zapta/ble_stepper_motor_analyzer/docs/ESP-WROOM-32-pinout.png

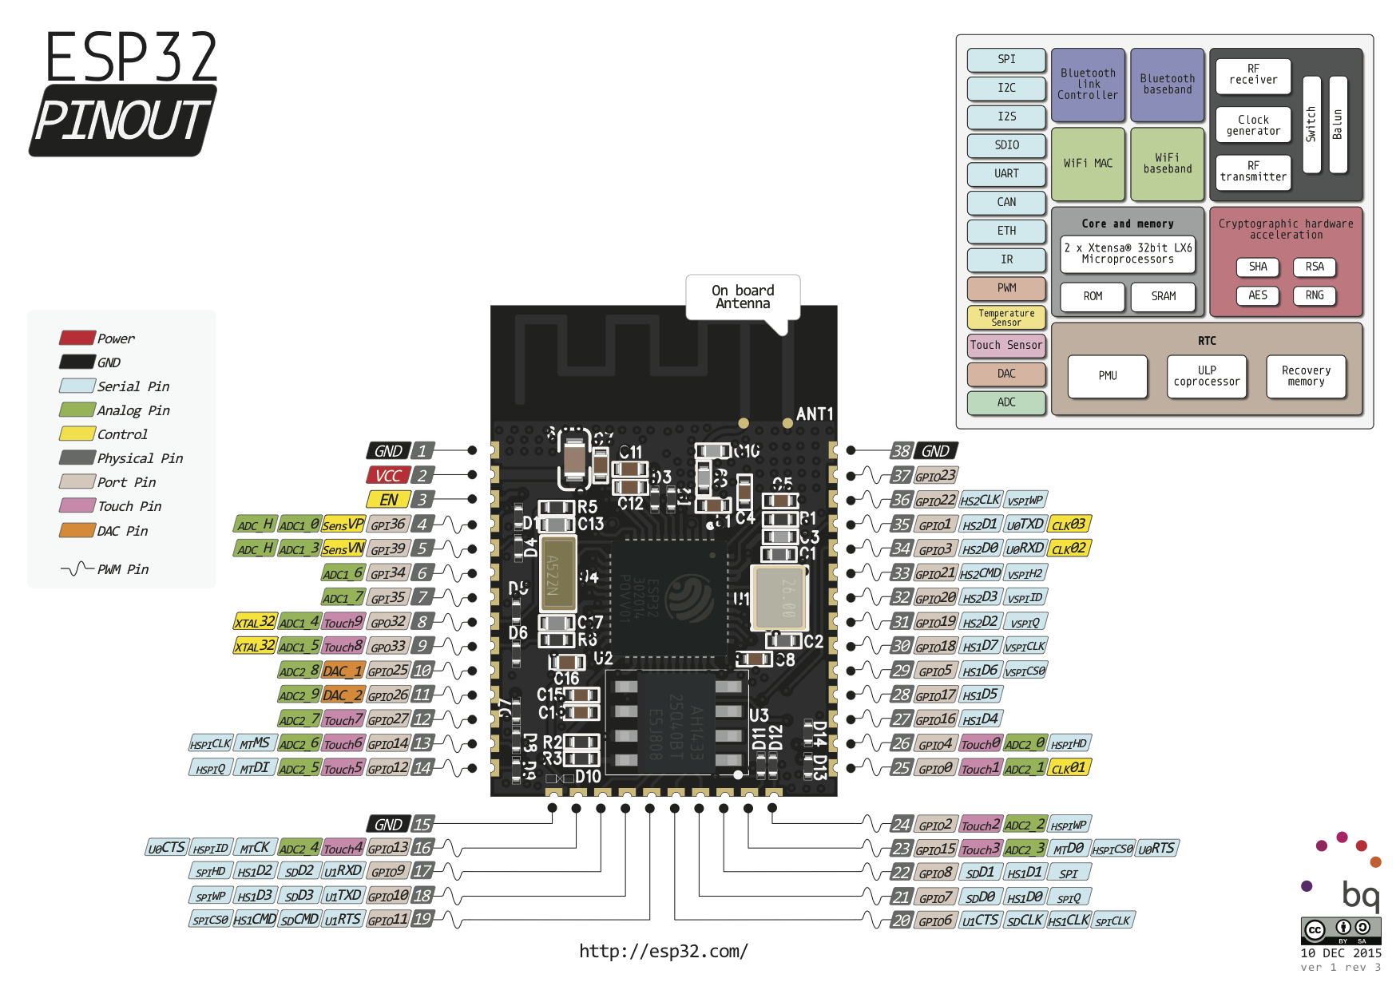
docs/ESP-WROOM-32-pinout.png
