zapta/ble_stepper_motor_analyzer/www/board_ortho.png

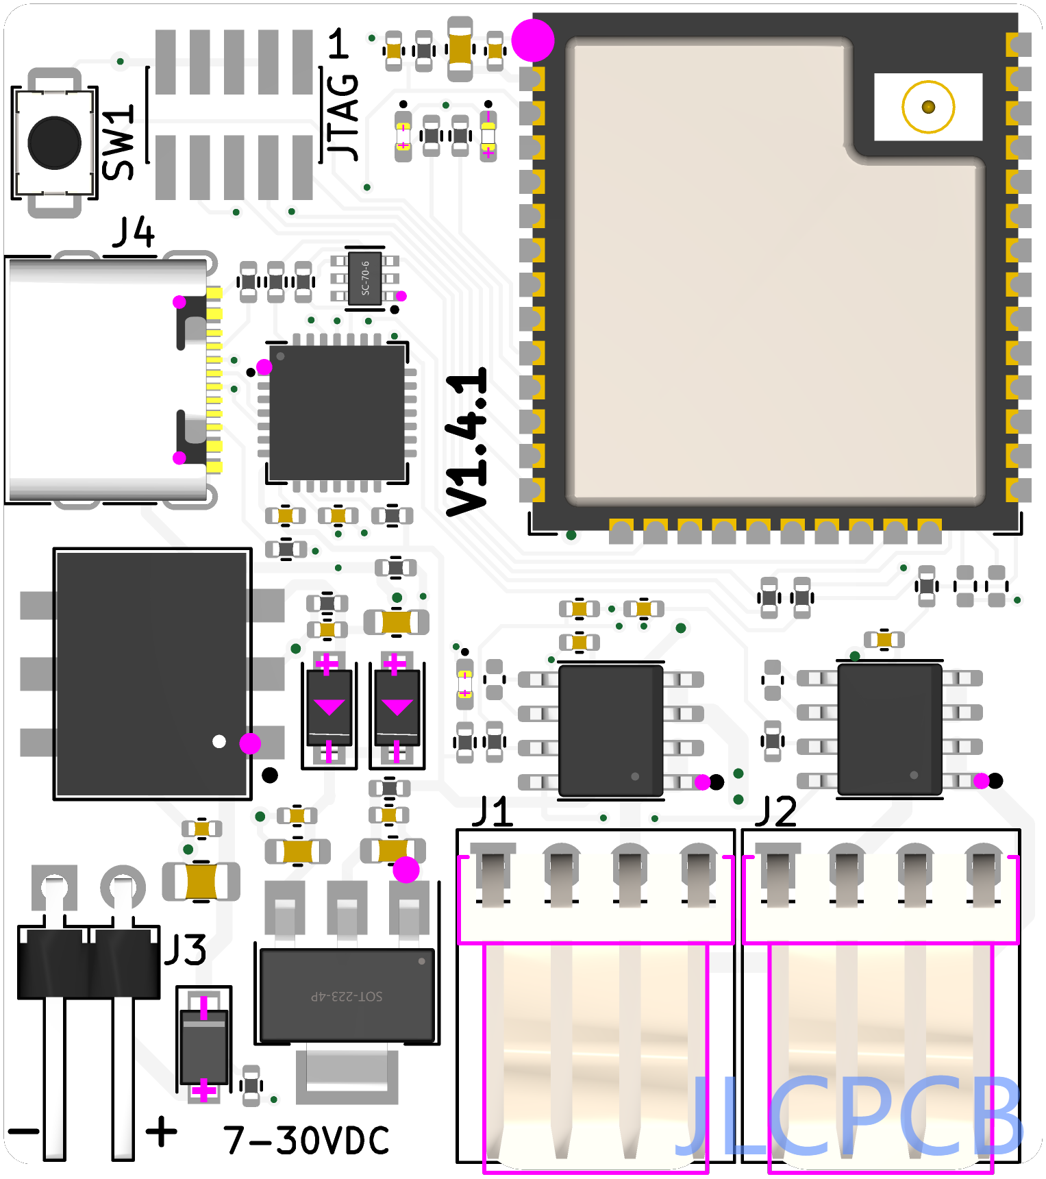
www/board_ortho.png
