zapta/ble_stepper_motor_analyzer/www/jlcpcb_top.png

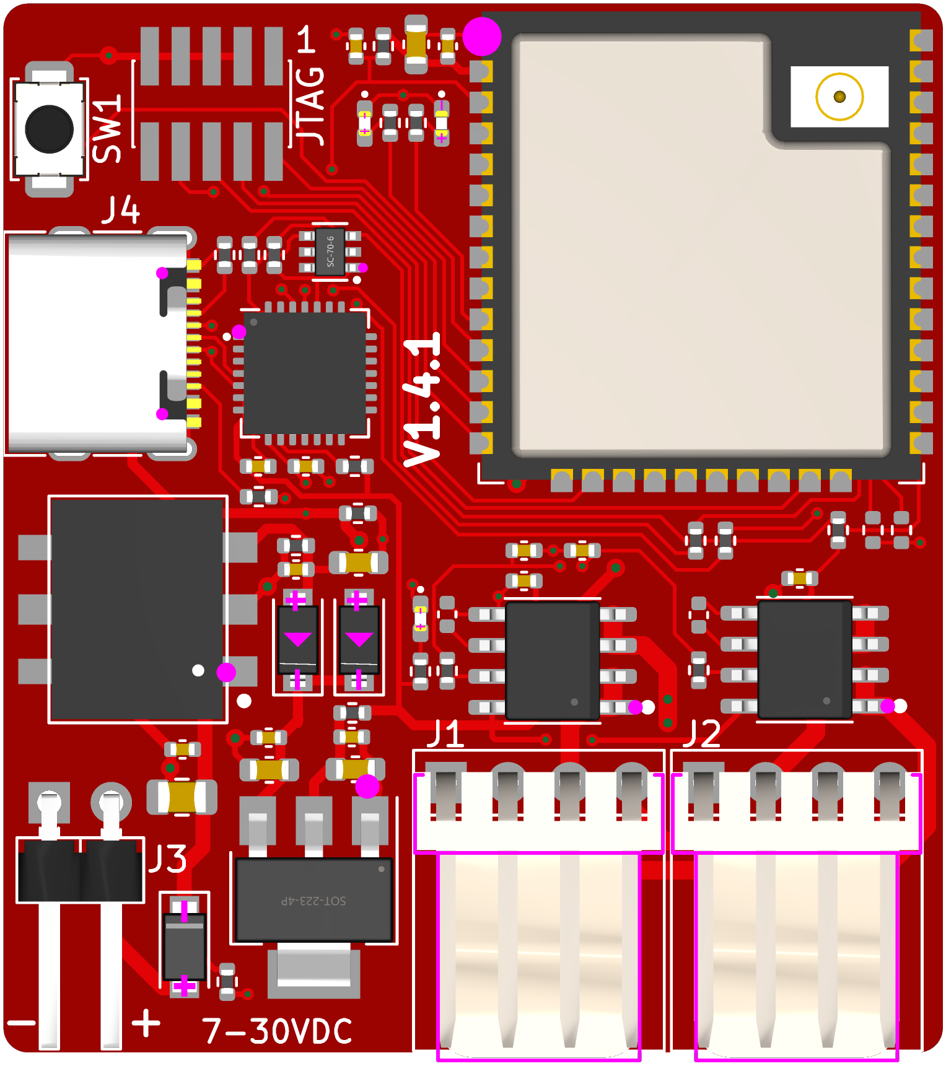
www/jlcpcb_top.png
