zapta/ble_stepper_motor_analyzer/docs/ESP32 Pins.xlsx

Sheet: WROOM
No. | Name | Type | GPIO | True GPIO | RTC_GPIO | ADC | TOUCH | DAC | I2C | SPI | SD/SDIO/MMC Host Controller | UART | Parallel QSPI | JTAG | SDIO Slave | Ethernet | SD/SDIO/MMC Host Controller
25 | IO00 | I/O | GPIO00 | No | RTC_GPIO11 | ADC2_CH01 | TOUCH1 |  |  |  |  |  |  |  |  | EMAC_TX_CLK |  | Low for programming
35 | TXD0 | I/O | GPIO01 | No |  |  |  |  |  |  |  | U0TXD |  |  |  | EMAC_RXD2
24 | IO02 | I/O | GPIO02 | No | RTC_GPIO12 | ADC2_CH02 | TOUCH2 |  |  |  | HS2_DATA0 |  | HSPIWP |  |  |  | HS2_DATA0 | floarting or low for flashing
34 | RXD0 | I/O | GPIO03 | No |  |  |  |  |  |  |  | U0RXD
26 | IO04 | I/O | GPIO04 |  | RTC_GPIO10 | ADC2_CH0 | TOUCH0 |  |  |  | HS2_DATA1 |  | HSPIHD |  |  | EMAC_TX_ER | HS2_DATA1
29 | IO05 | I/O | GPIO05 |  |  |  |  |  |  | SS/CS |  |  | VSPICS0 |  |  | EMAC_RX_CLK | HS1_DATA6
20 | SCK/CLK* | I/O | GPIO06 | No | UNUSABLE !!! (Flash memory) |  |  |  |  |  |  | U1CTS | SPICLK |  | SD_CLK |  | HS1_CLK
21 | SDO/SD0* | I/O | GPIO07 | No | UNUSABLE !!! (Flash memory) |  |  |  |  |  |  | U2RTS | SPIQ |  | SD_DATA0 |  | HS1_DATA0
22 | SDI/SD1* | I/O | GPIO08 | No | UNUSABLE !!! (Flash memory) |  |  |  |  |  |  | U2CTS | SPID |  | SD_DATA1 |  | HS1_DATA1
17 | SHD/SD2* | I/O | GPIO09 | No | UNUSABLE !!! (Flash memory) |  |  |  |  |  |  | U1RXD | SPIHD |  | SD_DATA2 |  | HS1_DATA2
18 | SWP/SD3* | I/O | GPIO10 | No | UNUSABLE !!! (Flash memory) |  |  |  |  |  |  | U1TXD | SPIWP |  | SD_DATA3 |  | HS1_DATA3
19 | SCS/CMD* | I/O | GPIO11 | No | UNUSABLE !!! (Flash memory) |  |  |  |  |  |  | U1RTS | SPICS0 |  |  |  | HS1_CMD
14 | IO12 | I/O | GPIO12 | No | RTC_GPIO15 | ADC2_CH05 | TOUCH5 |  |  |  | HS2_DATA2 |  | HSPIQ | MTDI |  | EMAC_TXD3 | HS2_DATA2 | Must not be high during boot!
16 | IO13 | I/O | GPIO13 |  | RTC_GPIO14 | ADC2_CH04 | TOUCH4 |  |  |  | HS2_DATA3 |  | HSPID | MTCK |  | EMAC_RX_ER | HS2_DATA3
13 | IO14 | I/O | GPIO14 |  | RTC_GPIO16 | ADC2_CH06 | TOUCH6 |  |  |  | HS2_CLK |  | HSPICLK | MTMS |  | EMAC_TXD2 | HS2_CLK
23 | IO15 | I/O | GPIO15 |  | RTC_GPIO13 | ADC2_CH03 | TOUCH3 |  |  |  | HS2_CMD |  | HSPICS0 | MTDO |  | EMAC_RXD3 | HS2_CMD | Prevents startup log
27 | IO16 | I/O | GPIO16 | Not available on WROVER |  |  |  |  |  |  |  | U2RXD |  |  |  | EMAC_CLK_OUT | HS1_DATA4 | PSRAM for the WROVER
28 | IO17 | I/O | GPIO17 | Not available on WROVER |  |  |  |  |  |  |  | U2TXD |  |  |  | EMAC_CLK_OUT_180 | HS1_DATA5 | PSRAM for the WROVER
30 | IO18 | I/O | GPIO18 |  |  |  |  |  |  | SCLK |  |  | VSPICLK |  |  |  | HS1_DATA7
31 | IO19 | I/O | GPIO19 |  |  |  |  |  |  | MISO |  | U0CTS | VSPIQ |  |  | EMAC_TXD0
33 | IO21 | I/O | GPIO21 |  |  |  |  |  | SDA1 |  |  |  | VSPIHD |  |  | EMAC_TX_EN
36 | IO22 | I/O | GPIO22 |  |  |  |  |  | SCL1 |  |  | U0RTS | VSPIWP |  |  | EMAC_TXD1
37 | IO23 | I/O | GPIO23 |  |  |  |  |  |  | MOSI |  |  | VSPID |  |  |  | HS1_STROBE
10 | IO25 | I/O | GPIO25 |  | RTC_GPIO06 | ADC2_CH08 |  | DAC_1 |  |  |  |  |  |  |  | EMAC_RXD0
11 | IO26 | I/O | GPIO26 |  | RTC_GPIO07 | ADC2_CH09 |  | DAC_2 |  |  |  |  |  |  |  | EMAC_RXD1
12 | IO27 | I/O | GPIO27 |  | RTC_GPIO17 | ADC2_CH07 | TOUCH7 |  |  |  |  |  |  |  |  | EMAC_RX_DV
8 | IO32 | I/O | GPIO32 |  | RTC_GPIO09 | ADC1_CH04 | TOUCH9 |  |  |  |  |  |  |  |  |  |  | XTAL_32K_P (32.768kHz crystal oscillator input)
9 | IO33 | I/O | GPIO33 |  | RTC_GPIO08 | ADC1_CH05 | TOUCH8 |  |  |  |  |  |  |  |  |  |  | XTAL_32K_N (32.768kHz crystal oscillator outut)
6 | IO34 | I | GPIO34 | No | RTC_GPIO04 | ADC1_CH06 |  |  |  |  |  |  |  |  |  |  |  | No internal pullup
7 | IO35 | I | GPIO35 | No | RTC_GPIO05 | ADC1_CH07 |  |  |  |  |  |  |  |  |  |  |  | No internal pullup
4 | SENSOR_VP | I | GPIO36 | No | RTC_GPIO00 | ADC1_CH0 |  |  |  |  |  |  |  |  |  |  |  | No internal pullup
5 | SENSOR_VN | I | GPIO39 | No | RTC_GPIO03 | ADC1_CH03 |  |  |  |  |  |  |  |  |  |  |  | No internal pullup

Sheet: ESP32 Chip
Name | No. | Type |  |  |  |  |  |  |  |  | Function
VDDA | 1 | P | Analog power supply (2.3V ~ 3.6V)
LNA_IN | 2 | I/O | RF input and output
VDD3P3 | 3 | P | Power supply (2.3V ~ 3.6V)
VDD3P3 | 4 | P | Power supply (2.3V ~ 3.6V)
SENSOR_VP | 5 | I | GPIO36 | ADC_PRE_AMP | ADC1_CH0 |  |  |  |  |  | RTC_GPIO0 Note: Connects a 270 pF capacitor from SENSOR_VP to SENSOR_ CAPP w
SENSOR_CAPP | 6 | I | GPIO37 | ADC_PRE_AMP | ADC1_CH1 |  |  |  |  |  | RTC_GPIO1 Note: Connects a 270 pF capacitor from SENSOR_VP to SENSOR_ CAPP w
SENSOR_CAPN | 7 | I | GPIO38 | ADC1_CH2 | ADC_PRE_AMP |  |  |  |  |  | RTC_GPIO2 Note: Connects a 270 pF capacitor from SENSOR_VN to SENSOR_ CAPN w
SENSOR_VN | 8 | I | GPIO39 | ADC1_CH3 | ADC_PRE_AMP |  |  |  |  |  | RTC_GPIO3 Note: Connects a 270 pF capacitor from SENSOR_VN to SENSOR_ CAPN w
CHIP_PU | 9 | I | High: On; enables the chip Low: Off; resets the chip Note: Do not leave the CHIP_PU pin floating.
VDET_1 | 10 | I | GPIO34 | ADC1_CH6 |  |  |  |  |  |  | RTC_GPIO4
VDET_2 | 11 | I | GPIO35 | ADC1_CH7 |  |  |  |  |  |  | RTC_GPIO5
32K_XP | 12 | I/O | GPIO32 | ADC1_CH4 | 32K_XP (32.768 kHz crystal oscillator input) | TOUCH9 |  |  |  |  | RTC_GPIO9
32K_XN | 13 | I/O | GPIO33 | ADC1_CH5 | 32K_XN (32.768 kHz crystal oscillator output) | TOUCH8 |  |  |  |  | RTC_GPIO8
GPIO25 | 14 | I/O | GPIO25 | ADC2_CH8 | DAC_1 | RTC_GPIO6 |  |  |  |  | EMAC_RXD0
GPIO26 | 15 | I/O | GPIO26 | ADC2_CH9 | DAC_2 | RTC_GPIO7 |  |  |  |  | EMAC_RXD1
GPIO27 | 16 | I/O | GPIO27 | ADC2_CH7 | TOUCH7 | RTC_GPIO17 |  |  |  |  | EMAC_RX_DV
MTMS | 17 | I/O | GPIO14 | ADC2_CH6 | TOUCH6 | RTC_GPIO16 | MTMS | HSPICLK | HS2_CLK | SD_CLK | EMAC_TXD2
MTDI | 18 | I/O | GPIO12 | ADC2_CH5 | TOUCH5 | RTC_GPIO15 | MTDI | HSPIQ | HS2_DATA2 | SD_DATA2 | EMAC_TXD3
VDD3P3_RTC | 19 | P | Input power supply for RTC IO (1.8V ~ 3.6V)
MTCK | 20 | I/O | GPIO13 | ADC2_CH4 | TOUCH4 | RTC_GPIO14 | MTCK | HSPID | HS2_DATA3 | SD_DATA3 | EMAC_RX_ER
MTDO | 21 | I/O | GPIO15 | ADC2_CH3 | TOUCH3 | RTC_GPIO13 | MTDO | HSPICS0 | HS2_CMD | SD_CMD | EMAC_RXD3
GPIO2 | 22 | I/O | GPIO2 | ADC2_CH2 | TOUCH2 | RTC_GPIO12 | HSPIWP | HS2_DATA0 |  |  | SD_DATA0
GPIO0 | 23 | I/O | GPIO0 | ADC2_CH1 | TOUCH1 | RTC_GPIO11 | CLK_OUT1
GPIO4 | 24 | I/O | GPIO4 | ADC2_CH0 | TOUCH0 | RTC_GPIO10 | HSPIHD | HS2_DATA1 | SD_DATA1 |  | EMAC_TX_ER
GPIO16 | 25 | I/O | GPIO16 | HS1_DATA4 | U2RXD |  |  |  |  |  | EMAC_CLK_OUT
VDD_SDIO | 26 | P | Output power supply: 1.8V or the same voltage as
GPIO17 | 27 | I/O | GPIO17 | HS1_DATA5 | U2TXD |  |  |  |  |  | EMAC_CLK_OUT_180
SD_DATA_2 | 28 | I/O | GPIO9 | SD_DATA2 | SPIHD | HS1_DATA2 | UNUSABLE !!! (Flash memory) |  |  |  | U1RXD
SD_DATA_3 | 29 | I/O | GPIO10 | SD_DATA3 | SPIWP | HS1_DATA3 | UNUSABLE !!! (Flash memory) |  |  |  | U1TXD
SD_CMD | 30 | I/O | GPIO11 | SD_CMD | SPICS0 | HS1_CMD | UNUSABLE !!! (Flash memory) |  |  |  | U1RTS
SD_CLK | 31 | I/O | GPIO6 | SD_CLK | SPICLK | HS1_CLK | UNUSABLE !!! (Flash memory) |  |  |  | U1CTS
SD_DATA_0 | 32 | I/O | GPIO7 | SD_DATA0 | SPIQ | HS1_DATA0 | UNUSABLE !!! (Flash memory) |  |  |  | U2RTS
SD_DATA_1 | 33 | I/O | GPIO8 | SD_DATA1 | SPID | HS1_DATA1 | UNUSABLE !!! (Flash memory) |  |  |  | U2CTS
GPIO5 | 34 | I/O | GPIO5 | VSPICS0 | HS1_DATA6 |  |  |  |  |  | EMAC_RX_CLK
GPIO18 | 35 | I/O | GPIO18 | VSPICLK |  |  |  |  |  |  | HS1_DATA7
GPIO23 | 36 | I/O | GPIO23 | VSPID |  |  |  |  |  |  | HS1_STROBE
VDD3P3_CPU | 37 | P | Input power supply for CPU IO (1.8V ~ 3.6V)
GPIO19 | 38 | I/O | GPIO19 | VSPIQ | U0CTS |  |  |  |  |  | EMAC_TXD0
GPIO22 | 39 | I/O | GPIO22 | VSPIWP | U0RTS |  |  |  |  |  | EMAC_TXD1
U0RXD | 40 | I/O | GPIO3 | U0RXD |  |  |  |  |  |  | CLK_OUT2
U0TXD | 41 | I/O | GPIO1 | U0TXD | CLK_OUT3 |  |  |  |  |  | EMAC_RXD2
GPIO21 | 42 | I/O | GPIO21 | VSPIHD |  |  |  |  |  |  | EMAC_TX_EN
VDDA | 43 | P | Analog power supply (2.3V ~ 3.6V)
XTAL_N | 44 | O | External crystal output
XTAL_P | 45 | I | External crystal input
VDDA | 46 | P | Digital power supply for PLL (2.3V ~ 3.6V)
CAP2 | 47 | I | Connects to a 3 nF capacitor and 20 kÎ© resistor in parallel
CAP1 | 48 | I | Connects to a 10 nF series capacitor to ground
GND | 49 | P | Ground
