zapta/ble_stepper_motor_analyzer/3D/shipping_covrer.stl

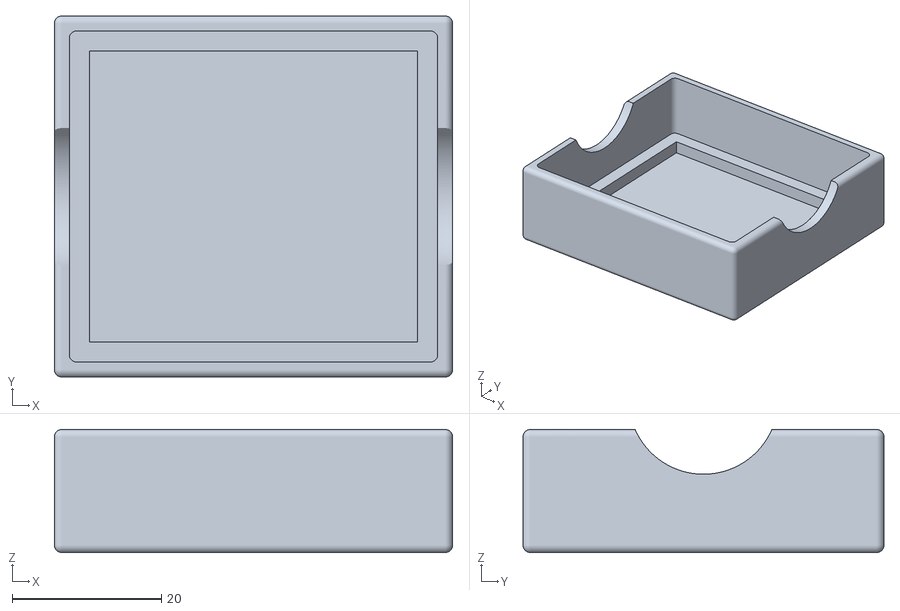
[picture p12: CAD file, 2023-02-09]
3D/shipping_covrer.stl
53.4 x 48.4 x 16.5
