zapta/ble_stepper_motor_analyzer/kicad/3d_models/tactile_switch.step

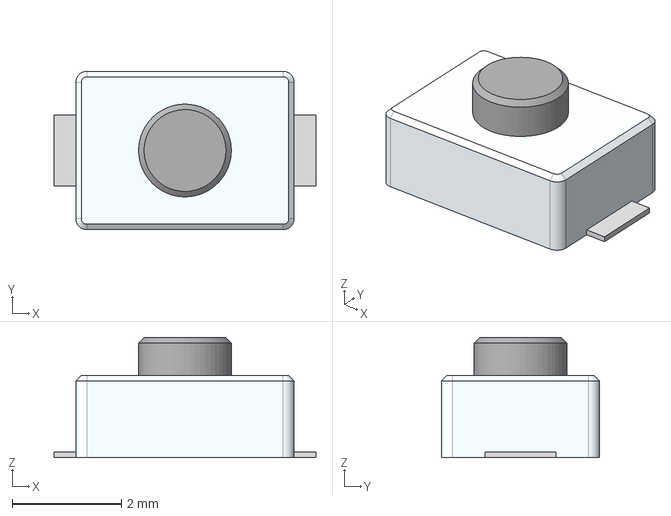
[picture p13: CAD file, 2023-03-21]
kicad/3d_models/tactile_switch.step
4.80 x 2.90 x 2.20 mm
