zapta/ble_stepper_motor_analyzer/3D/carrier.stl

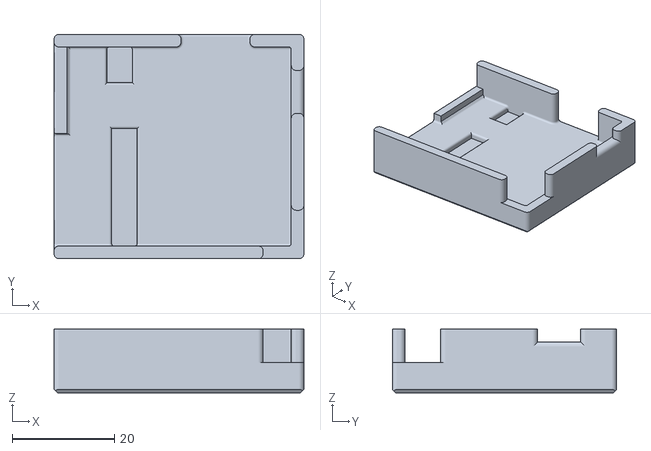
[picture p14: CAD file, 2023-02-09]
3D/carrier.stl
49.0 x 44.0 x 12.5
