zapta/ble_stepper_motor_analyzer/kicad/3d_models/K7805MT-500R4.step

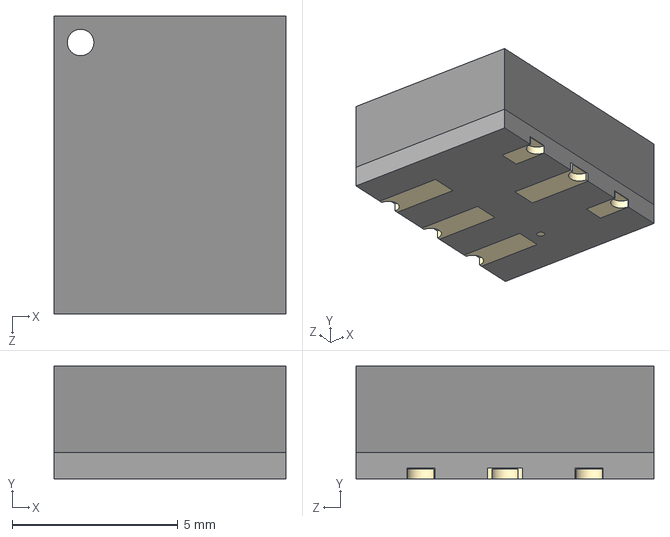
[picture p15: CAD file, 2023-03-20]
kicad/3d_models/K7805MT-500R4.step
7.00 x 3.40 x 9.00 mm
