zapta/ble_stepper_motor_analyzer/kicad/3d_models/kf2510_4p_right_angle.step

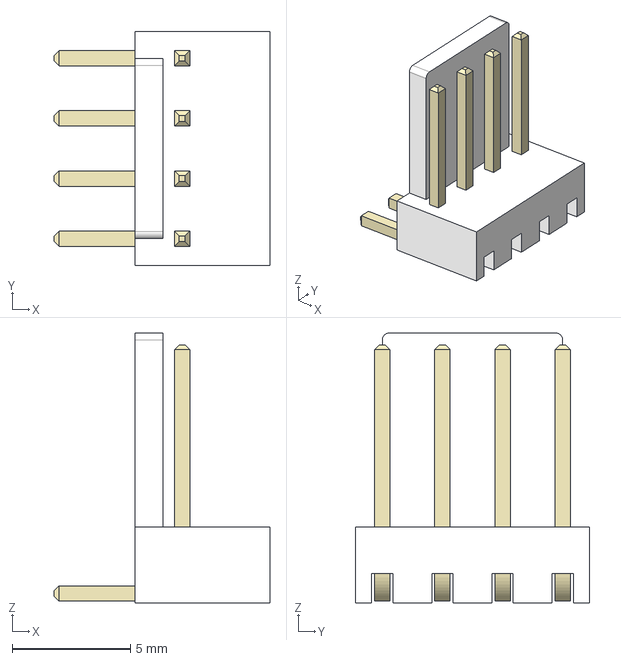
[picture p16: CAD file, 2023-03-20]
kicad/3d_models/kf2510_4p_right_angle.step
9.10 x 9.90 x 11.4 mm
