zapta/ble_stepper_motor_analyzer/kicad/3d_models/HRO_TYPE-C-31-M-12.step

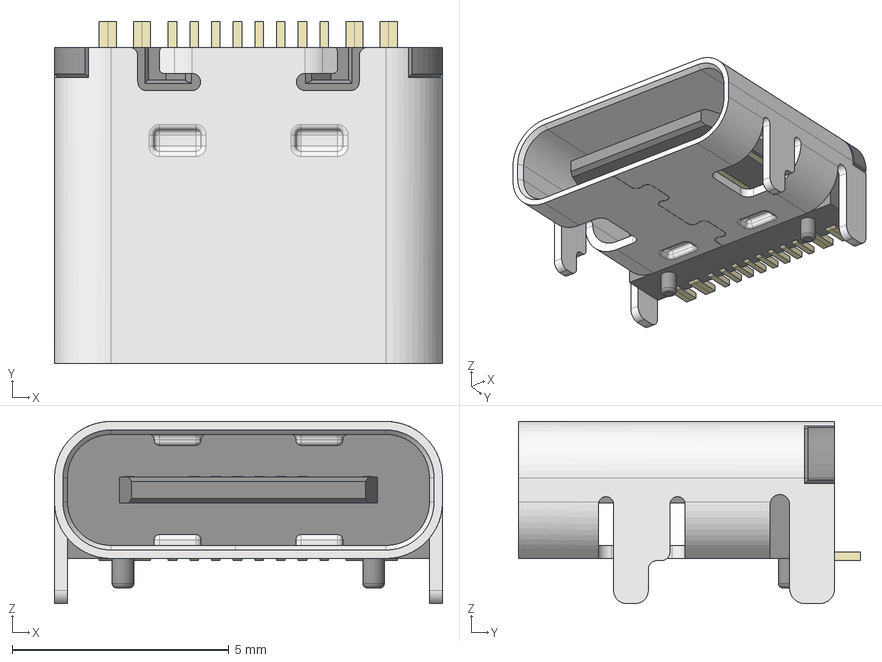
[picture p17: CAD file, 2023-03-20]
kicad/3d_models/HRO_TYPE-C-31-M-12.step
8.95 x 7.90 x 4.20 mm
