zapta/ble_stepper_motor_analyzer/TODO.txt

* Step tracking is not stable with very low stepper current, e.g. ~150ma after a Duet Home All function.

* In the device info, report also software version.

* Use github workflows to automate relase creation
