zapta/ble_stepper_motor_analyzer/(threads)

Thread 1 (2023-06-05):

Ordering at JLCPCB

Sineos, 2023-06-05:
Since I have never ordered something at JLC, some stupid questions:
1. 1.4.2 is good to go or are any major updated planned in the new future?
2. Ordering process:
   1. Upload `gerber.zip` --> Use JLC defaults
   2. Upload `bom.csv` and `positions.csv`
   3. C15,C18,R17,R18 are marked as `DNP` (= Do not populate / place?) --> Do not select them as well as the JTAG?
3. Anything else to mind?

Thanks for providing this cool design.

zapta, 2023-06-05:
Hi Sineos,

1. I ordered and tested successfully 1.4.1 (and have three units in my
printer).  1.4.2, is the same as 1.4.1 but automatically migrated to Kicad
7. I didn't test 1.4.2  it myself but somebody else made a few tweaks to
that design and ordered successfully. The tweaks involve changing the
connectors to more common ones with 3D controllers from China.

If all you want is hassle free one or two boards, they may be available for
sale in a month or two. I am not involved but will link on the main page
anybody that make them available to the community.

2. That's correct. If you consider making firmware development yourself,
add also the JTAG connector, at least on the board you want to use for
development (it's not a must but having a hardware debugger is handy). If
you just want to make and use the standard firmware than no need for the
JTAG connectors.

BTW, after I ordered my last batch, I think that JLCPCB now requires
'standard' level service to assemble the ESP32 modules.

3. What else? You will also need antennas, connectors, etc. If you are
handy with soldering, when you test the first unit, remove r16, and verify
that you have 3.3v on c11 with usb and/or external power. r16 is a short
that was placed for this reason, to disconnect the circuitry from the power
supply.

Wish you success, and I will try to help if needed, but basically this
reference design is 'as is' with no warranties.

Zapta

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

Sineos, 2023-06-06:
Thanks a lot @zapta

zapta, 2023-06-08:
Sineos, FYI, a BLE Stepper Motor Analyzer is now available from a third party.

https://vector3d.co.uk/product/stepper-motor-analyser/

Closed 2023-06-06.

Thread 2 (2023-06-10):

Max current

dzid26, 2023-06-10:
If the design uses CC6920BSO-5A, shouldn't it be -/+5A range? The readme says +/-2.5A per phase

zapta, 2023-06-11:
It needs 5v supply to have the +/-5A range with 400mv/A sensitivity but in
this design we run it on 3.3V only. But anyway, +/-2.5A peak is more than
needed for most 3D printers.

BTW, there is a better current sensor with the same pinout but it's very
hard to find since the pandemic, especially non fake ones (I did get fakes
once from Aliexpress, it's easy to identify since pins 1,2 and 3,4
respectively should be shorted internally). The ACS70331EESATR-2P5B3  has
higher bandwidth, lower noise, and lower output impedance. The output
impedance is important because the ESP32 ADC has relatively low output
impedance and loads the CC6920BSO-5A such that we don't really get 400mv/A.
This is why we calibrated it using actual measurements with ESP32 and not
based on the datasheet.

https://github.com/zapta/ble_stepper_motor_analyzer/blob/main/platformio/src/acquisition/acq_consts.h#L11

The two configuration resistors R17, R18 were designed to support 4
different kinds of sensors, to let the firmware know which one is
installed, but CC6920BSO-5A is the only one we used in this design because
it's available on JLCPCB.

Zapta

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

dzid26, 2023-06-11:
> It needs 5v supply to have the +/-5A range with 400mv/A sensitivity but in this design we run it on 3.3V only.

Are you saying that the real sensitivity of CC6920BSO-5A is 400mV/A ?
But as someone also pointed out (https://forum.duet3d.com/post/292525) the data sheet says 264mV/A. Which makes sense because this chip us designed for 3.3V.
And you mentioned in the forum that impedance maybe is not an issue..

zapta, 2023-06-19:
Yes, you are right, I may mixed it with another sensor.

BTW, I see that digikey carries now some Allegro GMR sensors, they have higher bandwidth and significantly lower noise. Ideally the +/-2.5A with 400mv/A, but the +/-5A with 200mv/A can still be more quieter than the one from JLCPCB.

file:///C:/Users/user/Downloads/ACS70331-Datasheet.pdf

(Having all the components available from JLCPCB was a key design goal here, hence the selection of the inferior current sensor. In previous designs which I soldered myself I used the Alegro ones, e.g. https://github.com/zapta/simple_stepper_motor_analyzer/blob/main/kicad/stepper_analyzer.pdf )

dzid26, 2023-06-20:
Today I designed a voltage-measuring circuit that filters scales down, and offsets the phase voltage. It is using a differential opamp configuration - so the ground doesn't have to be connected.
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
https://everycircuit.com/circuit/5156012797198336/biased-differential-amplifier-

I don't know how noisy it will be and what can be done with it, but power calculation should be possible.

But now I am thinking - it would be interesting to use the same structure (but with different gain and less filtering) to also measure current across 0.1ohm shunt resistors. I think I will put it in parallel with CC6920BSO to compare the noise of both solutions.

I wonder if the noise you mention is also related to flawed ADC from ESP32 and additionally lack of filtering of analog VDD3p3 in Wroom module. Would be cool to replace it with a [custom design](https://youtu.be/yxU_Kw2de08?t=418), but I have enough of Kicad.

zapta, 2023-06-20:
I believe that the noise is dominated by the JLCPCB current sensor because when I hooked the ESP32 to a ACS70331  +/-2.5A the noise reduction was very visible.

As for your circuit, one thing that the magnetic current sensors provide is galvanic isolation which the opamp circuit doesn't provide, so make sure to get the connections and voltages right so you don't damage anything or experiment with an ESP32 that runs on a battery.

There are also isolated amplifiers if you want to get fancy ;-). Never used them but they seem interesting. E.g. https://www.ti.com/product/AMC3311-Q1

Thread 3 (2023-06-10):

Repo size

dzid26, 2023-06-10:
The repo size is approaching 1GB.
Can you move the /releases (analyzer.exe, analyzer, firmware) to github releases and [rewrite git history](https://stackoverflow.com/questions/11050265/remove-large-pack-file-created-by-git) while still not many people has forked it?

I also like putting PCB gerbers, pdfs and [ibom](https://github.com/zapta/ble_stepper_motor_analyzer/blob/main/kicad/bom/ibom.html) in release as well.

Nordic sniffer probably also can be removed.

dzid26, 2023-06-10:
I did [it](https://docs.github.com/en/authentication/keeping-your-account-and-data-secure/removing-sensitive-data-from-a-repository) in my [fork](https://github.com/dzid26/ble_stepper_motor_analyzer).

```
java -jar bfg.jar --delete-files stepper_monitor-2023-06-10_153440.zip
java -jar bfg.jar --delete-files stepper_monitor-2023-06-10_145755.zip
java -jar bfg.jar --delete-files nrf_sniffer_for_bluetooth_le_4.1.1.zip
java -jar bfg.jar --delete-files ibom.html
java -jar bfg.jar --delete-files positions.csv
java -jar bfg.jar --delete-files gerber.zip
java -jar bfg.jar --delete-files bom.csv
java -jar bfg.jar --delete-files bootloader.bin
java -jar bfg.jar --delete-files firmware.bin
java -jar bfg.jar --delete-files partitions.bin
java -jar bfg.jar --delete-files analyzer
java -jar bfg.jar --delete-files analyzer.exe
java -jar bfg.jar --delete-files bluetooth_spec_Core_v4.2.pdf
java -jar bfg.jar --delete-files bluetooth_spec_Core_v5.3.pdf
```

```
git push --force
git reflog expire --expire=now --all && git gc --prune=now --aggressive
```

Now it's 157MB + [releases](https://github.com/dzid26/ble_stepper_motor_analyzer/releases/tag/0.1.4.V3D).

zapta, 2023-06-10:
Hi @dzid26,

Can you reply here with your your suggestions for repo structure changes and I will check with @AdamV3D if it will not disturb his fork at https://github.com/AdamV3D/ble_stepper_motor_analyser.   A text description should do, e.g. 'move file x to location z'.

BTW, the esptool is included in the release to allow users to perform firmware upgrade in the field.

Thanks,
Zapta

zapta, 2023-06-10:
... another useful change would be to generate the 3 python binaries on the
github servers instead of locally. I think github supports this kind of
functionality (for Windows, Mac, and Linux) but never used it and not sure
if it's included with the free plan.

Zapta.

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

dzid26, 2023-06-10:
I [moved](https://github.com/dzid26/ble_stepper_motor_analyzer/commit/446ccf57ebdc2c621b7545003fa04f5d7a8207e6) esptool to the tools folder, because it made sense.

I think releases should be fairly rare, so it's ok if they contain Kicad, firmware, and PC - all together.  If someone wants the latest stuff they will probably be compiling things themselves anyway.

Yes, Github Actions should be able to generate firmware and even gerberas. I have [examples](https://github.com/dzid26/StepperServoCAN/actions/runs/5217466463) of [such ](https://github.com/dzid26/StepperServo-hardware/actions/runs/4039163312) generation (with resulted files at the bottom) however I never figured out how to make it appear in releases. Still useful if someone just needs the latest bin.

@AdamV3D 's fork would break in the sense that automated merging would stop being possible as it will have "unrelated history".
I actually [merged](https://github.com/dzid26/ble_stepper_motor_analyzer/pull/1) their changes already in my fork, but I removed the branding.

AdamV3D, 2023-06-10:
I'm not too fussed about what goes where, as long as there is some logic to it and you let me know what I need to change.

dzid26, 2023-06-10:
@zapta
If you are happy with the file list that I pruned from the repo, you can simply add my fork to your remotes `git remote add dzid_repo https://github.com/dzid26/ble_stepper_motor_analyzer.git`, then `git reset --hard be5677df7288d70ab088b6f44482682492ed3467` to be on my be5677df7288d70ab088b6f44482682492ed3467 (or this one 237ca533ef51c63852ebdcca41b90d53d2e325d2), and at the end you `git push --force` to Github.

Thread 5 (2023-06-24):

Running Analyzer App on a Raspberry Pi

thijstriemstra, 2023-06-24:
> The Analyzer App ('the app'). This is a Python program that runs on a Windows, MaC OSX, or Linux PC, and displays the stepper information in real time in a graphical view.

After some research it looks like PyQT is used for the analyzer app so it should be able to run on a Raspberry Pi? I have a Raspberry Pi 3 with a HyperPixel display running KlipperScreen, would be great to use the app on that device (besides KlipperScreen) and use the touchscreen etc.

Was  the app ever tested on a Raspberry Pi?

zapta, 2023-06-25:
Hi Thijs,

I tested the app on Ubuntu with a X86 processor but never a Raspberry.
Would be interesting to give it a try if you can.

The BLE communication is done using Bleak Python library
https://github.com/hbldh/bleak which may use native drivers so I would
check first if it supports The Raspberry Pie.

Please keep us updated.

Zapta

On Sat, Jun 24, 2023 at 11:20 AM Thijs Triemstra ***@***.***>
wrote:

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

Thread 6 (2023-06-25):

[Q] Working?

Sineos, 2023-06-25:
I have received a bunch from JLCPCB.
I'd be grateful if you could take a look at https://drive.google.com/file/d/1WODmPNKCghbgU1xkgDg3Vb5cSd95qMt8/view
Is this what is to be expected, i.e. does it work like it should?

Basically just
```
G0 F9000 X245.0
G0 F9000 X1.0
```
repeated on a 0.9 stepper with 64 microsteps.

zapta, 2023-06-25:
Looks very good.  The driver maintains a clean signal and high current at
high speed.

I cannot see well the current graph (third from the top). Ideally it should
be flat except for idle timeout where some drivers lower the current when
the motor doesn't move. Can you send me a closeup that shows the signal and
the Y axis?

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

Sineos, 2023-06-25:
Playing around with the new toy currently :-)

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

What I'm wondering:

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

Why is this so asymmetrical, i.e. the Lissajous figure shifted to the right and top and the oscilloscope graph also shifted upwards?

zapta, 2023-06-25:
Yes, I think that you need to calibrate the zeros of your sensor, it's a
one time thing, and it may also solve the fluctuations in the third graph
from the top.

1. With the power off, disconnect the stepper cables (to have zero current)
2. Power the analyzer the analyzer
3. Press on the button on the PCB for a few seconds until the LED will
blink 3 times, to indicate that the zero calibration values were stored
properly on the device.

Please let me know how it worked for you.

Also, since you have multiple boards, you may want to look into the 'nick
name' feature https://github.com/zapta/ble_stepper_motor_analyzer . You can
assign board names such as MOTOR_X or EXTRUDER and then use those names
instead of the numeric ids.

Zapta.

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

zapta, 2023-06-25:
... the third graph (current) shows the radius of the circle you see in the
phase graph so if it's not centered by zero calibration, the radius is
different in different angles and thus the third graph shows fluctuation,
depending at what phase it happened to sample the X and Y currents. Very
interesting. Never seen it before because I always zero calibrate the
sensors first.

Zapta.

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

Sineos, 2023-06-26:
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

*Sigh* A classic case of RTFM. Thanks for your support. Appreciated!

zapta, 2023-06-26:
Awesome.  Thanks for updating me.

I learned something new.

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

Sineos, 2023-06-26:
Thanks for the work and effort you put into providing this!

Closed 2023-06-26.

Thread 9 (2023-11-16):

Max stepper voltage? 48V?

ganzgustav22, 2023-11-16:
Does it support steppers that run 48V?

7-30V is just the supply voltage, right?

zapta, 2023-11-16:
That's correct. I believe that 48V steppers should be fine.

It's just a matter of insulation of the current sensors, connectors, PCB
traces, etc. There is no electronic component that is directly exposed to
the 48V.

On Thu, Nov 16, 2023 at 11:43 AM ganzgustav22 ***@***.***>
wrote:

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
