zapta/ble_stepper_motor_analyzer/kicad/stepper_monitor.pdf

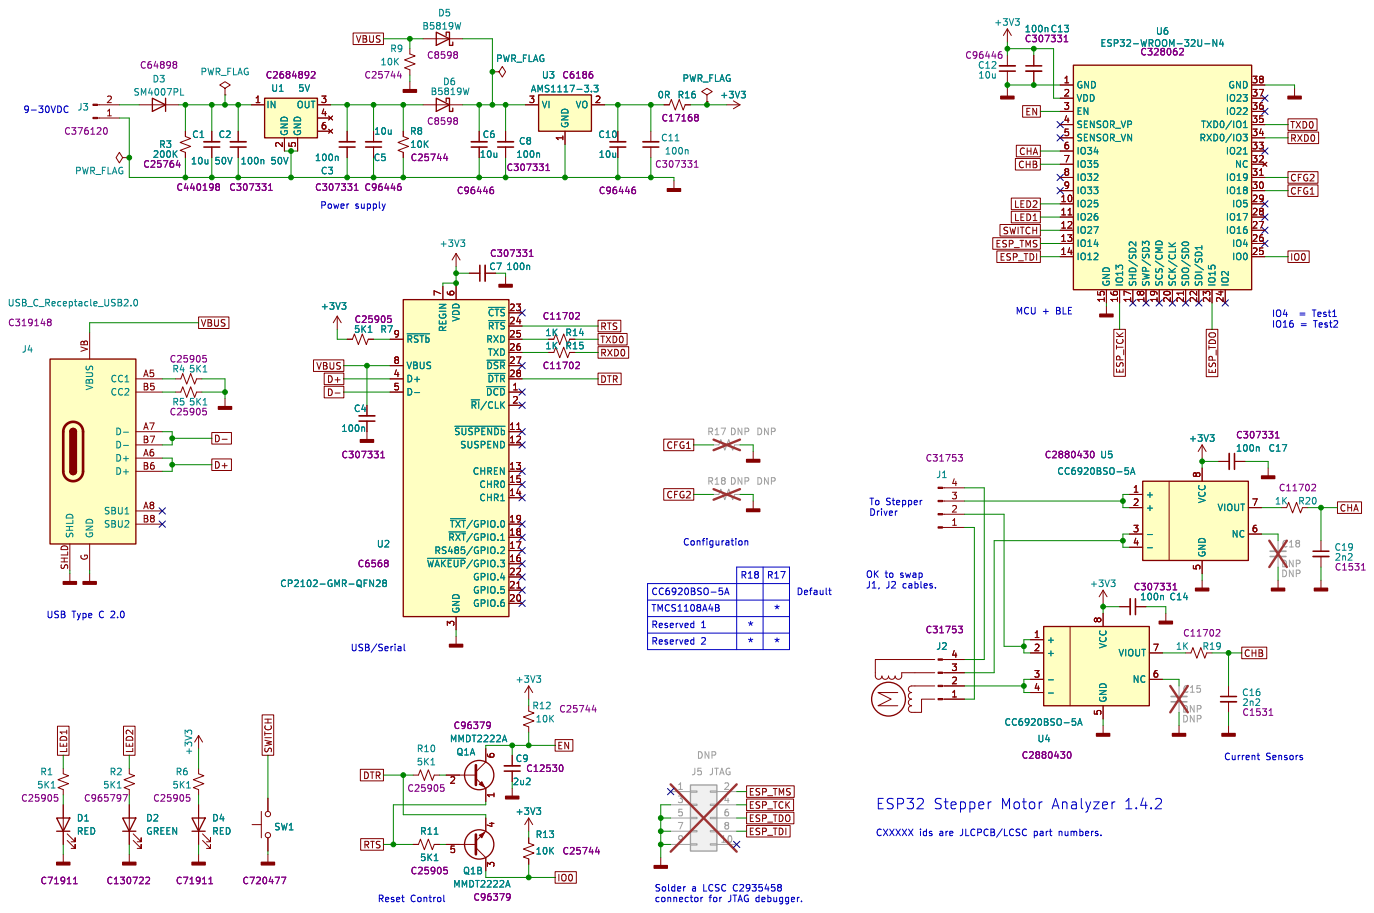
[picture p18: page 1]

To Stepper Driver OK to swap
