zapta/ble_stepper_motor_analyzer/hardware/stepper_monitor.pdf

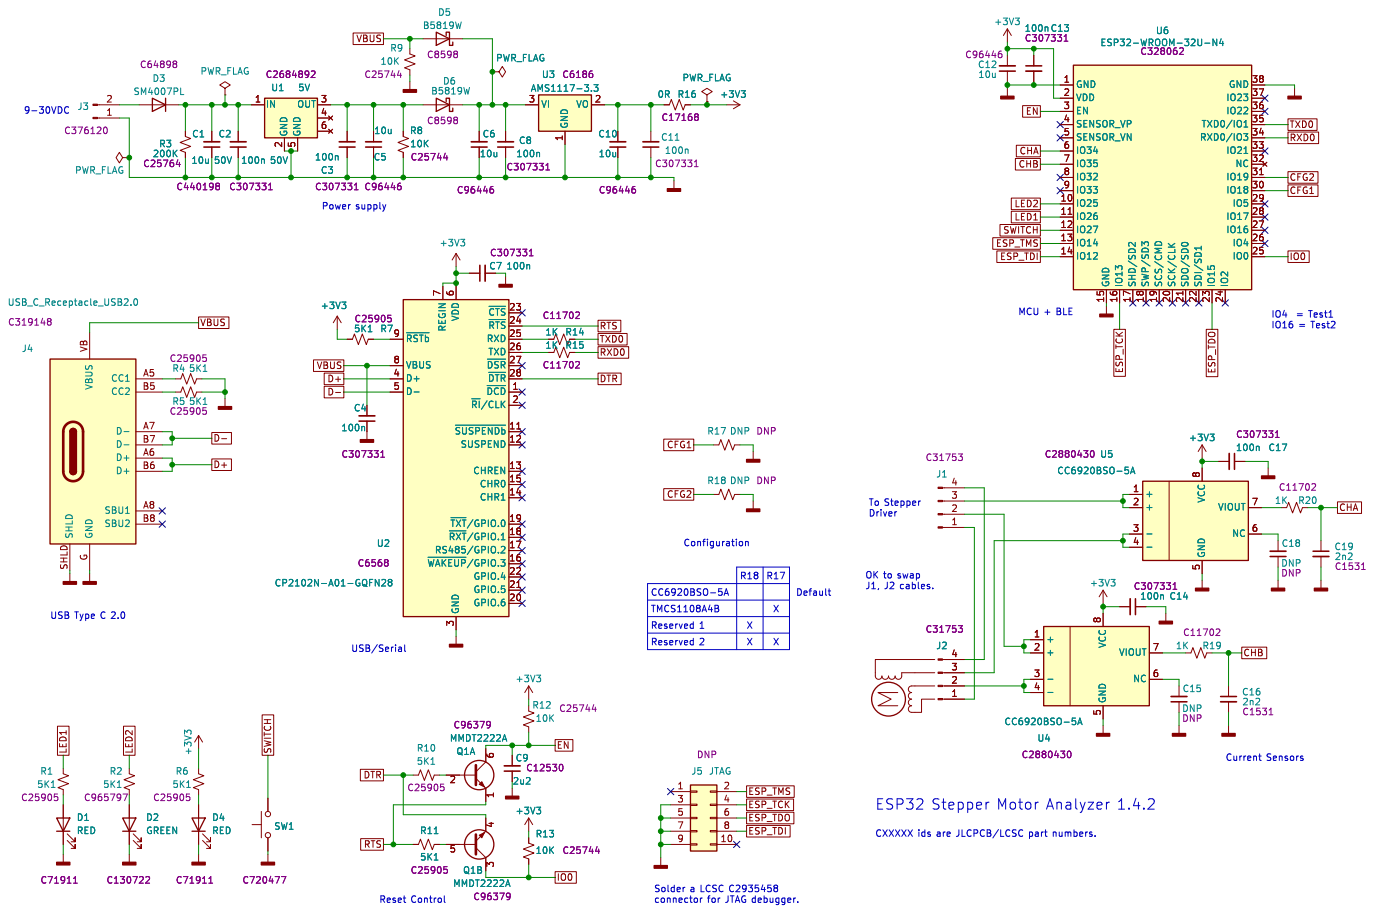
[picture p19: page 1]

7 VBUS 8 ~{RSTb} 9 U2 CP2102N-A01-GQFN28 C6568 +3V3 C15 DNP DNP C16
