zapta/ble_stepper_motor_analyzer/hardware/stepper_monitor_pcb.pdf

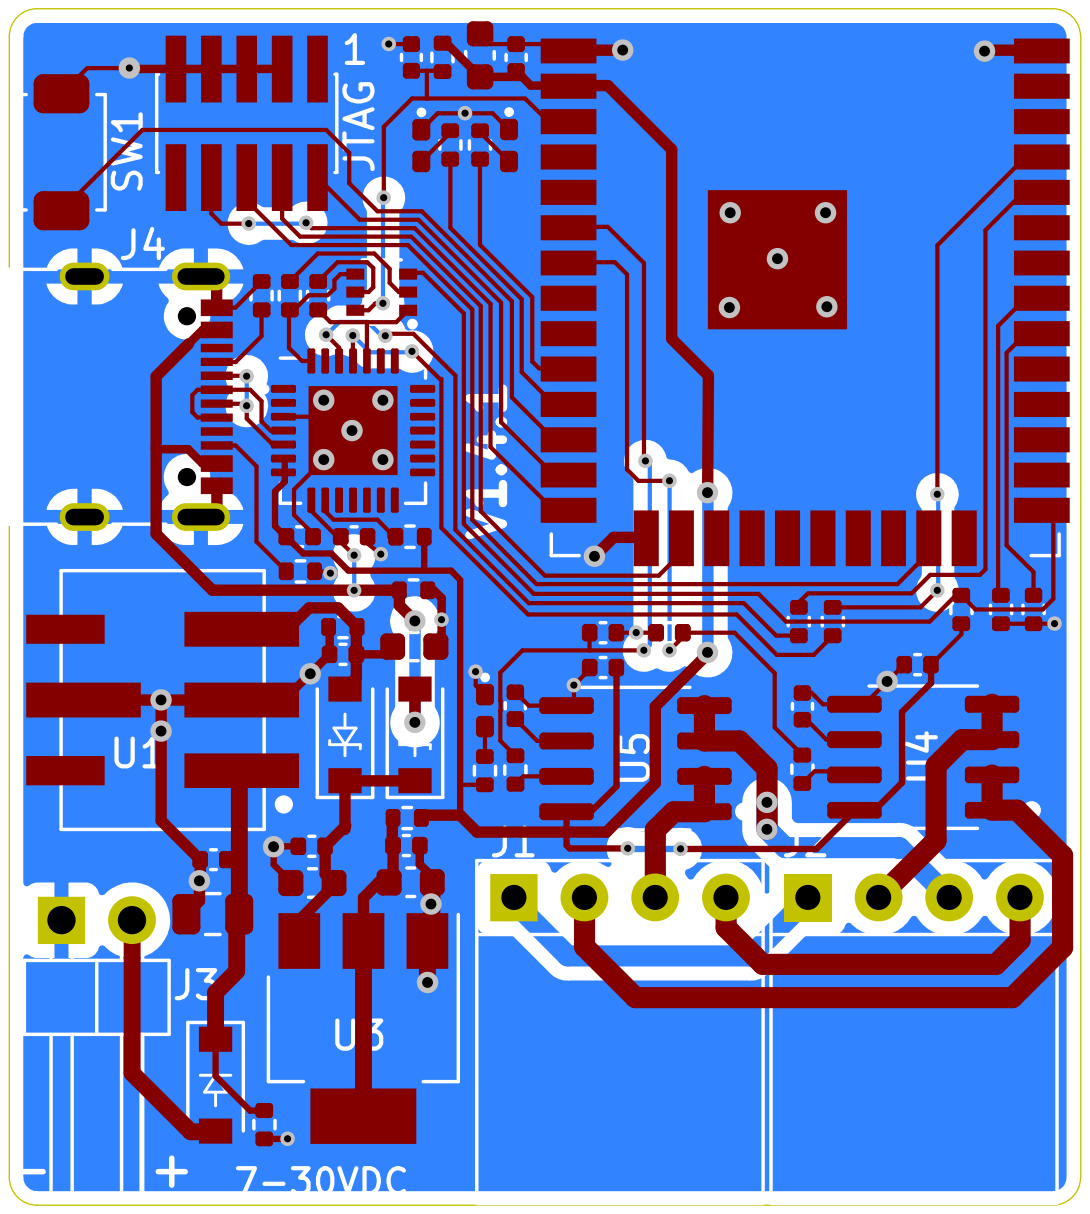
[picture p20: page 1]
