zapta/ble_stepper_motor_analyzer/(commit log)

2022-08-31 Initial esp32 project.
2022-09-01 Regenerated the ESP32 startup project.
2022-09-04 Works with ESP32 mini
2022-09-04 Initial esp32 kicad.
    [stepper_monitor.kicad_pcb, stepper_monitor.sch]
2022-09-06 Updated to Kicad 6
    [stepper_monitor.kicad_pcb, stepper_monitor.kicad_sch, stepper_monitor.sch]
2022-09-08 Work in progress.
    [ESP32 Pins.xlsx, stepper_monitor.kicad_pcb, stepper_monitor.kicad_sch]
2022-09-10 Updated the schematic: Fixed the power selection circuit.
    [stepper_monitor.kicad_sch]
2022-09-10 Cleaned up a few footprints.
    [stepper_monitor.kicad_pcb, stepper_monitor.kicad_sch]
2022-09-11 Initial placement and routing. Needs TLC.
    [stepper_monitor.kicad_pcb, stepper_monitor.kicad_sch]
2022-09-11 Fixed non available JLCPCB parts.
    [stepper_monitor.kicad_pcb, stepper_monitor.kicad_sch]
2022-09-11 Topologically correct routing. Needs TLC.
    [stepper_monitor.kicad_pcb, stepper_monitor.kicad_sch]
2022-09-11 Cleaned up the layout.
    [stepper_monitor.kicad_pcb, stepper_monitor.kicad_sch]
2022-09-11 Connected USB shield to ground.
    [stepper_monitor.kicad_pcb, stepper_monitor.kicad_sch]
2022-09-13 Cleaned up the PCB layout.
    [stepper_monitor.kicad_pcb, stepper_monitor.kicad_sch]
2022-09-13 Minor PCB layout tweaks.
    [stepper_monitor.kicad_pcb, stepper_monitor.kicad_sch]
2022-09-15 Added i/o and button logic.
2023-01-01 adc works, 20k 1 chan
2023-01-01 Updated analog input pins.
    [stepper_monitor.kicad_pcb, stepper_monitor.kicad_sch]
2023-01-05 Added test point.
    [stepper_monitor.kicad_pcb, stepper_monitor.kicad_sch]
2023-01-05 Adjusted ADC offset.
2023-01-12 Added ADC capacitors.
    [stepper_monitor.kicad_pcb, stepper_monitor.kicad_sch]
2023-01-14 Stable ADC sampling.
2023-01-14 Added LEDs blinks.
2023-01-14 Added led blinks (leftover files)
2023-01-17 BLE work in progress. Device name now includes device address.
2023-01-21 Deleted an orphan arduino file
2023-01-25 Added pin TEST2.
    [stepper_monitor.kicad_sch]
2023-01-26 Updated capacitor value from 4u7 to 2u2.
    [stepper_monitor.kicad_sch]
2023-01-26 Change adc filter caps from 4.7n to 2.2n
    [stepper_monitor.kicad_pcb, stepper_monitor.kicad_sch]
2023-01-26 Calibrated current sensors.
2023-01-26 Updated led and npn to available parts.
    [stepper_monitor.kicad_pcb, stepper_monitor.kicad_sch]
2023-01-27 Updated PCB for external antenna + cleanups.
    [stepper_monitor.kicad_pcb, stepper_monitor.kicad_sch]
2023-01-27 Fixed schematic footprints.
    [stepper_monitor.kicad_sch]
2023-01-28 Cleaned up library reference
    [stepper_monitor.kicad_pcb, stepper_monitor.kicad_sch]
2023-01-28 Added JLCPCB production files.
    [bom.csv, positions.csv]
2023-01-28 Changed yellow LED to green.
    [stepper_monitor.kicad_sch]
2023-01-28 Added parsing of device name and merged the scanner into the analyzer.
2023-01-29 Added automatic selection of devices.
2023-01-29 Added nrf snifer for wireshak.
2023-02-08 Minor tweaks.
    [carrier.stl, shipping_covrer.stl]
2023-02-08 Changed solder jumper to 0 ohms resistor.
    [bom.csv, positions.csv, stepper_monitor.kicad_pcb, stepper_monitor.kicad_sch]
2023-02-08 Deleted obsolete Kicad files.
    [stepper_monitor.sch]
2023-02-09 Added 3D models
    [carrier.stl, shipping_covrer.stl]
2023-02-10 Added printout of efuses.
2023-02-11 Simplify the power supply using a diode based design.
    [stepper_monitor.kicad_pcb, stepper_monitor.kicad_sch]
2023-02-12 Renamed directory 'kicad' to 'hardware'.
    [bom.csv, positions.csv, stepper_monitor.kicad_pcb, stepper_monitor.kicad_sch]
2023-02-12 Generated JLCPCB produciton files.
    [bom.csv, positions.csv, stepper_monitor.kicad_sch]
2023-02-15 Changed LCSC part number of green LED
    [bom.csv, stepper_monitor.kicad_pcb, stepper_monitor.kicad_sch]
2023-02-16 Renamed jj5 to j5. Increased version to 1.4.2. This is one commit past order of 1.4.1 from JLCPCB.
    [stepper_monitor.kicad_pcb, stepper_monitor.kicad_sch]
2023-02-22 Addeed device side disconnection.
2023-02-25 Upgraded kicad to 7.0 (design version incremented to 1.4.2)
    [bom.csv, positions.csv, stepper_monitor.kicad_pcb, stepper_monitor.kicad_sch]
2023-02-26 Renamed directories to kicad, platformio, and python. No other change.
    [bom.csv, positions.csv, stepper_monitor.kicad_pcb, stepper_monitor.kicad_sch]
2023-02-28 Fixed nvs write crash. Updated firmware binary files.
    [adc_task.cpp]
2023-02-28 Added list of available linux chip drivers
2023-02-28 Updated to full linux bt drivers (firmware files)
2023-02-28 Fixed the device sorting.
    [connections.py]
2023-03-06 Changed device lookup from by address to by name.
2023-03-19 Changed the tasks to not block the timer handler.
2023-03-20 Added 3D models, regenerated production files (new plugin version). No electrical changes.
    [HRO_TYPE-C-31-M-12.step, K7805MT-500R4.step, bom.csv, kf2510_4p_right_angle.step, stepper_monitor.kicad_pcb]
2023-03-21 Added device version string.
2023-03-21 Added 3d model for the switch.
    [tactile_switch.step]
2023-03-21 Added 3D model for tactile switch.
    [stepper_monitor.kicad_pcb, stepper_monitor.kicad_sch]
2023-03-22 Renamed flag --device-nick-name to --device-nickname.
2023-03-24 Upgraded kicad 7.0.0 -> 7.0.1
    [stepper_monitor.kicad_pcb]
2023-04-05 Added support for device side nickname.
2023-04-06 Added to the scan printout of rssi
2023-04-06 Adapted test to use device name instead of address.
2023-04-08 Fixed the atexit disconnect on widnows. Disabled WDT heatbeat.
    [connections.py, probe.py]
2023-04-08 Forcing exit(0) as a workaround for Mac OSX zsh printing error messages on exit.
    [connections.py]
2023-06-24 Added a discussion of max stepper voltage that can be used.
2023-07-11 Fixe the part number of the USB serial IC to CP2102 (was CP2102N). The LCSC part number C6568 was correct and was not changed..
    [bom.csv, stepper_monitor.kicad_sch]
